OLIMEX/Bike-TSL-Kit/README.md

# Bike-TSL-Kit

[Bike-TSL-Kit](https://www.olimex.com/Products/Soldering-Kits/Bike-TSL-Kit/open-source-hardware) is soldering kit which adds Audi style turn signal lights to your bike.

# License
- Hardware is with CERN OHL v1.2 license
- Documentation is with CC BY-SA 4.0 license
