OLIMEX/Bike-TSL-Kit/HARDWARE/Bike-TSL-Kit.Rev-A/Bike-TSL-Kit_RevA.BOM.pdf

Bike-TSL-Kit_RevA

Page 1

Designation | Quantity | Designator | Package
0805 10 UF X7R 6.3V 10% | 4 | C1,C2,C3,C4 | C_0805
1N5822_SS34_SMA | 2 | D1,D2 | SMA-KA
1206 220 OHM 5% | 11 | R1,R2,R3,R4,R5,R13,R14,R17,R19,R21,R23 | R_1206
0805 22 K 5% | 13 | R6,R7,R8,R9,R10,R11,R12,R15,R16,R18,R20,R22,R24 | R_0805
CD43 4.7 UH (NRS4018T4R7MDGJ) | 1 | L1 | CD43
BAT HOLDER 1xAA | 1 | BAT1 | BATTERY-1xAA
BL8536CB3TR33 | 1 | U2 | SOT89
LED RED 10MM | 10 | LED1..LED10 | LED10mmPTH
LM339D | 3 | U1,U3,U4 | SOIC-14_150mil
