OLIMEX/Bike-TSL-Kit/HARDWARE/Bike-TSL-Kit.Rev-A/3d/BAT_1xAA_HOLDER.step

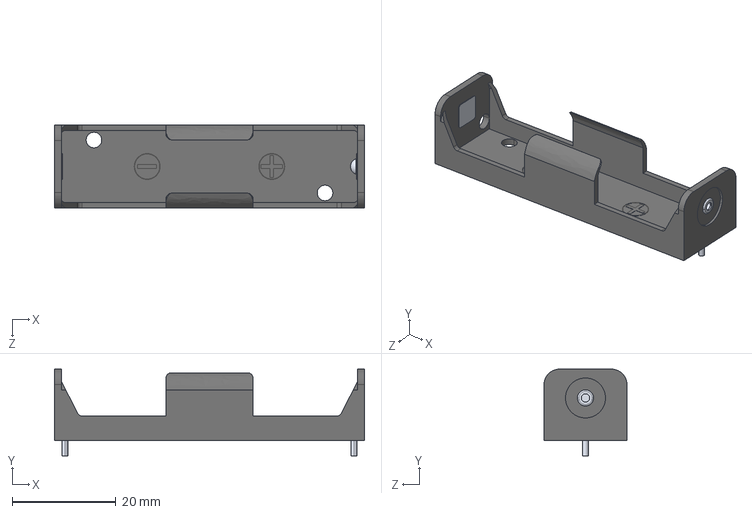
[picture p1: CAD file, 2019-10-22]
HARDWARE/Bike-TSL-Kit.Rev-A/3d/BAT_1xAA_HOLDER.step
59.7 x 16.7 x 16.0 mm
