OLIMEX/Bike-TSL-Kit/HARDWARE/Bike-TSL-Kit.Rev-A/3d/SL14.step

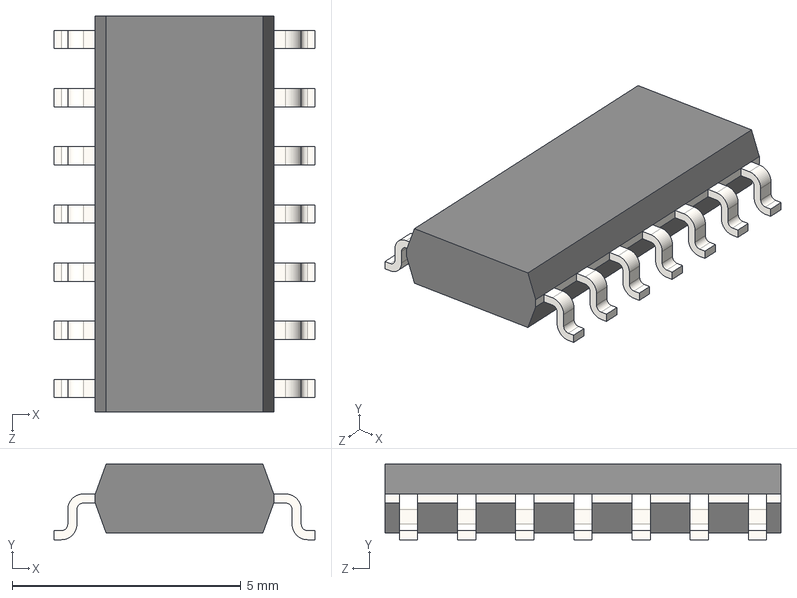
[picture p2: CAD file, 2019-10-22]
HARDWARE/Bike-TSL-Kit.Rev-A/3d/SL14.step
5.70 x 1.65 x 8.65 mm
