OLIMEX/Bike-TSL-Kit/HARDWARE/Bike-TSL-Kit.Rev-A/3d/DURACEL_LR6_AA_BATTERY.step

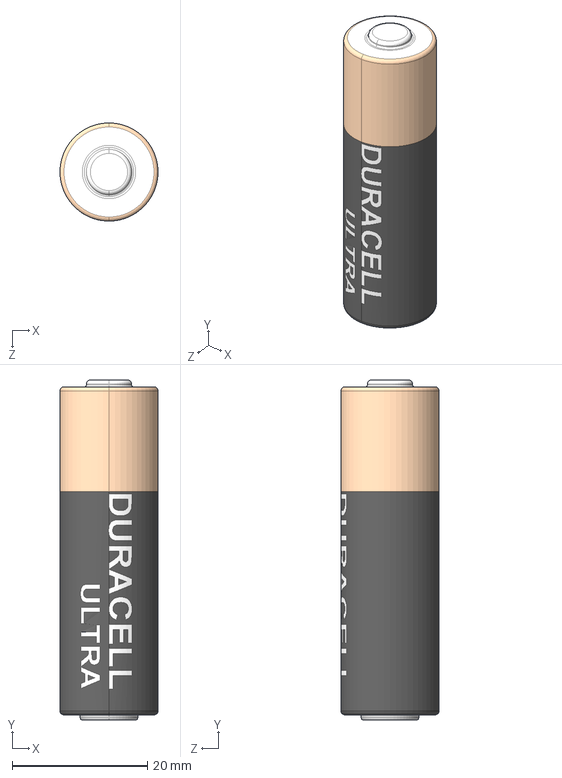
[picture p3: CAD file, 2019-10-22]
HARDWARE/Bike-TSL-Kit.Rev-A/3d/DURACEL_LR6_AA_BATTERY.step
14.5 x 50.2 x 14.5 mm
