OLIMEX/Bike-TSL-Kit/HARDWARE/Bike-TSL-Kit.Rev-A/3d/SOT-89.step

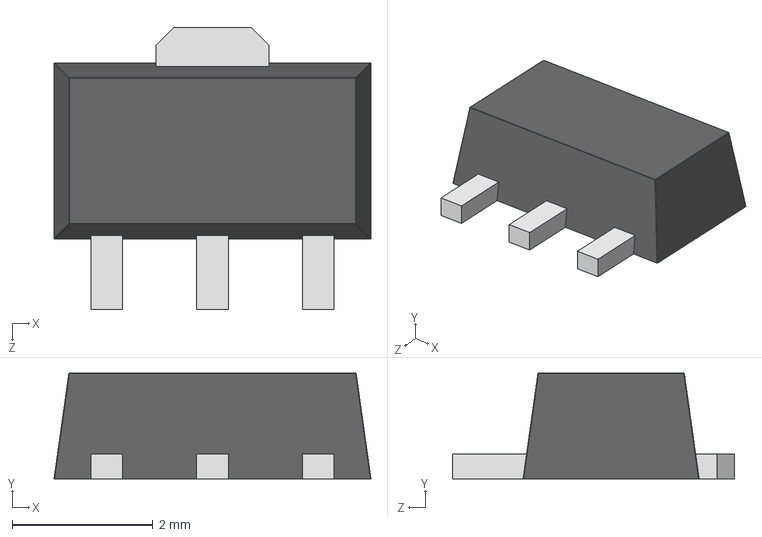
[picture p4: CAD file, 2019-10-22]
HARDWARE/Bike-TSL-Kit.Rev-A/3d/SOT-89.step
4.50 x 1.50 x 4.00 mm
