OLIMEX/Bike-TSL-Kit/HARDWARE/Bike-TSL-Kit.Rev-A/3d/L-CD43_shielded.STEP

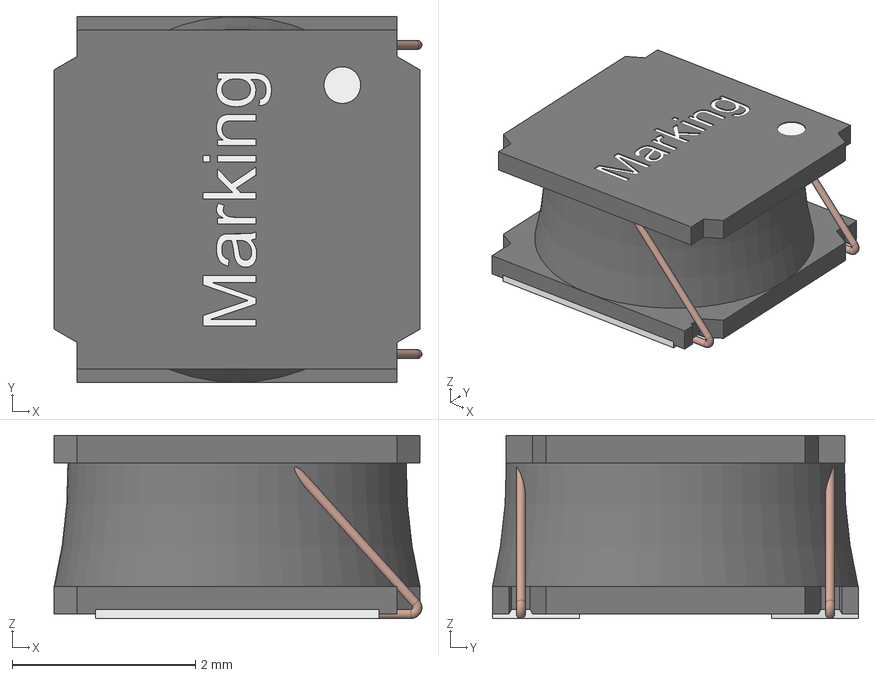
[picture p5: CAD file, 2019-10-22]
HARDWARE/Bike-TSL-Kit.Rev-A/3d/L-CD43_shielded.STEP
4.02 x 4.00 x 2.00 mm
housing
contact x 2
Glue
Wire x 2
