OLIMEX/Bike-TSL-Kit/HARDWARE/Bike-TSL-Kit.Rev-A/3d/SOT-23.step

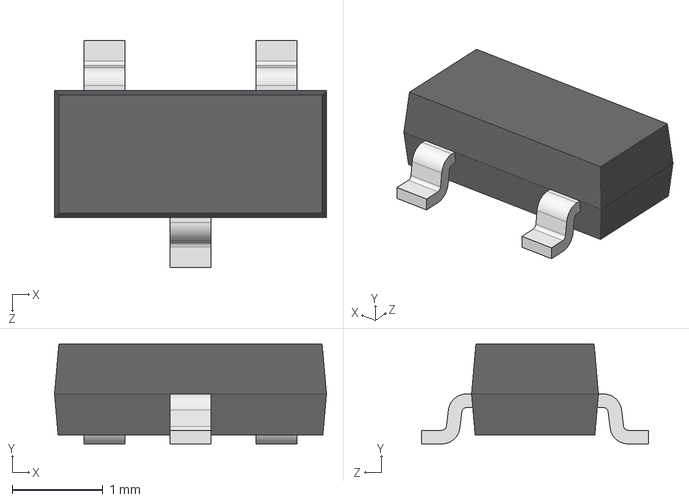
[picture p6: CAD file, 2019-10-22]
HARDWARE/Bike-TSL-Kit.Rev-A/3d/SOT-23.step
3.00 x 1.10 x 2.50 mm
