OLIMEX/Bike-TSL-Kit/HARDWARE/Bike-TSL-Kit.Rev-A/3d/DO-214AC_SMA.step

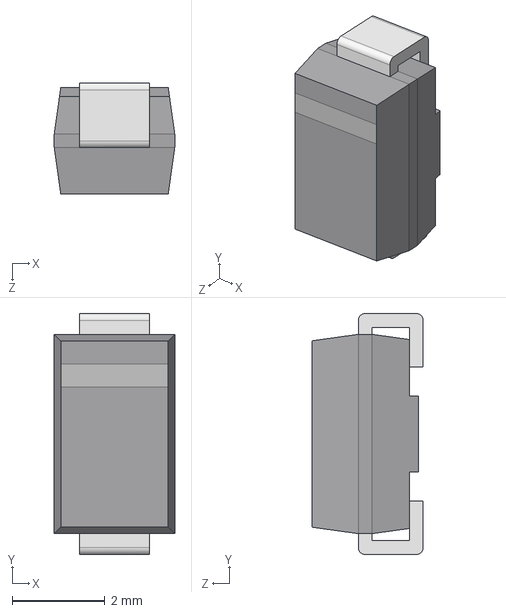
[picture p7: CAD file, 2019-10-22]
HARDWARE/Bike-TSL-Kit.Rev-A/3d/DO-214AC_SMA.step
2.60 x 5.20 x 2.40 mm
