OLIMEX/Bike-TSL-Kit/HARDWARE/Bike-TSL-Kit.Rev-A/Bike-TSL-Kit_RevA.pdf

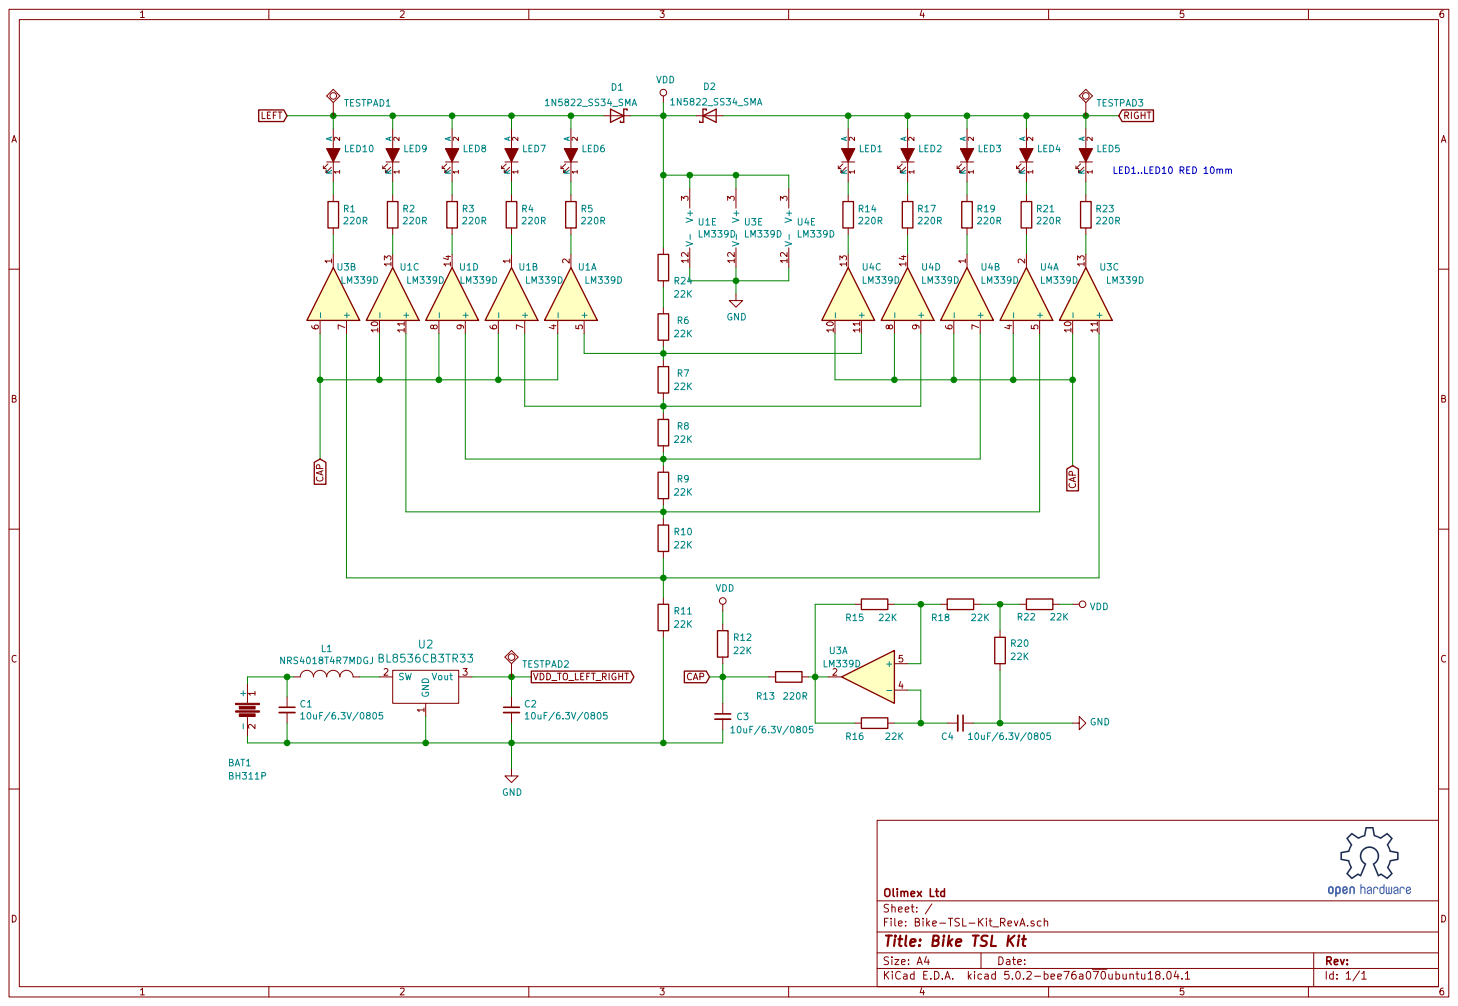
[picture p8: page 1]

File: Bike-TSL-Kit_RevA.sch Sheet: / Olimex Ltd R9

Id: 1/1 Title: Bike TSL Kit
