OLIMEX/Bike-TSL-Kit/HARDWARE/Bike-TSL-Kit.Rev-A/Bike-TSL-Kit_RevA.kicad_pcb

## KiCad design HARDWARE/Bike-TSL-Kit.Rev-A/Bike-TSL-Kit_RevA.kicad_pcb (2019-10-22)

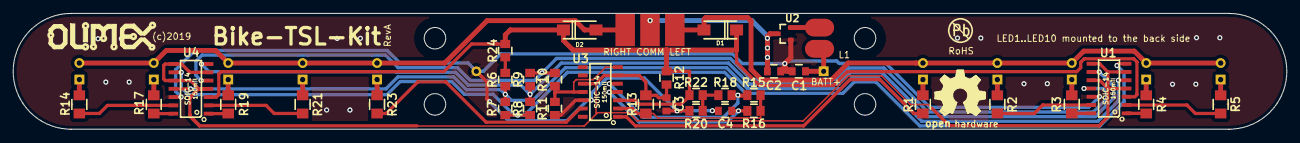
[picture p9: board Bike-TSL-Kit_RevA.kicad_pcb from above]

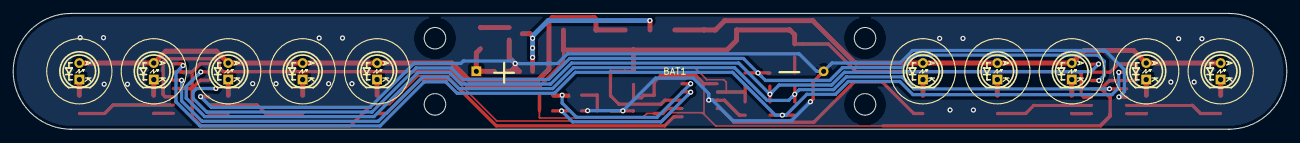
[picture p10: board Bike-TSL-Kit_RevA.kicad_pcb from below]

Board: 2 copper layers, 195.6 x 17.8 mm, 53 parts (11 on the bottom side), 38 nets.

Parts:
BAT1: Battery; BATTERY-1xAA
C1, C2, C3, C4: 10uF; C_0805_5MIL_DWS
D1, D2: 1N5822_SS34_SMA; SMA-KA
L1: 4.7uH; CD43
LED1, LED2, LED3, LED4, LED5, LED6, LED7, LED8, LED9, LED10: LED; LED10mmPTHKA
MountingHole*: Mounting_hole_3.3mm
MountingHole*#2, MountingHole*#3, MountingHole*#4: Mounting_hole_3.3mm
R1, R2, R3, R4, R5, R13, R14, R17, R19, R21, R23: 220R; R_1206_5MIL_DWS
R6, R7, R8, R9, R10, R11, R12, R15, R16, R18, R20, R22, R24: 22K; R_0805_5MIL_DWS
TESTPAD1, TESTPAD2, TESTPAD3: TESTPAD; TP_SMD_10.00x3.00mm
U1, U3, U4: LM339; SOIC-14_150mil
U2: BL8536; SOT23

Connections:
CAP: C3.1, R12.2, R13.2, U1.4, U1.6, U1.8, U1.10, U3.6, U3.10, U4.4, U4.6, U4.8, U4.10
GND: BAT1.2, C1.2, C2.2, C3.2, C4.1, R11.2, R20.1, U1.12, U2.1, U3.12, U4.12
LEFT: D1.2, LED6.2, LED7.2, LED8.2, LED9.2, LED10.2, TESTPAD1.1
unnamed: BAT1.1, C1.1, L1.1
unnamed: C4.2, R16.2, U3.4
unnamed: L1.2, U2.2
unnamed: LED1.1, R14.1
unnamed: LED2.1, R17.1
unnamed: LED3.1, R19.1
unnamed: LED4.1, R21.1
unnamed: LED5.1, R23.1
unnamed: LED6.1, R5.1
unnamed: LED7.1, R4.1
unnamed: LED8.1, R3.1
unnamed: LED9.1, R2.1
unnamed: LED10.1, R1.1
unnamed: R1.2, U3.1
unnamed: R2.2, U1.13
unnamed: R3.2, U1.14
unnamed: R4.2, U1.1
unnamed: R5.2, U1.2
unnamed: R6.2, R7.1, U1.5, U4.11
unnamed: R7.2, R8.1, U1.7, U4.9
unnamed: R8.2, R9.1, U1.9, U4.7
unnamed: R9.2, R10.1, U1.11, U4.5
unnamed: R10.2, R11.1, U3.7, U3.11
unnamed: R13.1, R15.1, R16.1, U3.2
unnamed: R14.2, U4.13
unnamed: R15.2, R18.1, U3.5
unnamed: R17.2, U4.14
unnamed: R18.2, R20.2, R22.2
unnamed: R19.2, U4.1
unnamed: R21.2, U4.2
unnamed: R23.2, U3.13
unnamed: R6.1, R24.2
RIGHT: D2.2, LED1.2, LED2.2, LED3.2, LED4.2, LED5.2, TESTPAD3.1
VDD: D1.1, D2.1, R12.1, R22.1, R24.1, U1.3, U3.3, U4.3
VDD_TO_LEFT_RIGHT: C2.1, TESTPAD2.1, U2.3
