OLIMEX/Bike-TSL-Kit/DOCUMENTATION/bike-tsl-kit-manual-fr.pdf

# Guide de montage du Bike-TSL-Kit

1. Souder les circuits intégrés U1, U2, U3, U4. Faites attention à la marque PIN1 de U1,U3,U4.
2. Soudez les résistances 1206 220 ohm (marque 221) : R1, R2, R3, R4, R5, R13, R14, R17, R19, R21, R23
3. Souder les résistances 0805 22 k ohm (marque 223) : R6, R7, R8, R9, R10, R11, R12, R15, R16, R18, R22, R22, R24
4. Souder les condensateurs 0805 10uF/6,3V : C1, C2, C3, C4
5. Souder les diodes SMA 1N5822 : D1, D2. Attention à la polarité, attention à la marque !
6. Souder l'inducteur CD43 4.7uH L1
7. Souder les LED : LED1 ... LED10. Le fil long va dans le pad circulaire.
8. Soudez le support de la pile. Faites attention aux signes plus et moins.
9. Retirez l'isolation des câbles des boutons et soudez-les de cette façon :
Les fils rouges vers les pads droit et gauche, les deux fils noirs vers le pad COMM.
