OLIMEX/Bike-TSL-Kit/DOCUMENTATION/bike-tsl-kit-manual-bg.pdf

# Bike-TSL-Kit

1. Запояват се интегрални схеми: U1, U2, U3, U4. Обърнете внимание за поляритета.
2. Запояват се резисторите 1206 220 ом: R1, R2, R3, R4, R5, R13, R14, R17, R19, R21, R23
3. Запояват се резисторите 0805 22 к: R6, R7, R8, R9, R10, R11, R12, R15, R16, R18, R22, R22, R24
4. Запояват се кондензаторите 0805 10uF/6.3V: C1, C2, C3, C4
5. Запояват се диодите SMA 1N5822: D1, D2. Внимание има поляритет!
6. Запоява се бобината CD43 4.7uH L1
7. Запояват се светодиодите: LED1 ... LED10. Дългият извод в кръглия пад.
8. Запоява се държача за батерията. Да се спазят означенията за + и –.
9. Зачистват се кабелите към бутоните и се запояват на падовете както следва: Червените съответно на Right и Left, черните двата заедно на COMM.
