OLIMEX/Bike-TSL-Kit/(notices)

Notices in the files:
HARDWARE/Bike-TSL-Kit.Rev-A/Bike-TSL-Kit_RevA.kicad_pcb:
(c)2019
